G8GYW/g8gyw.github.io/MiniCore.png

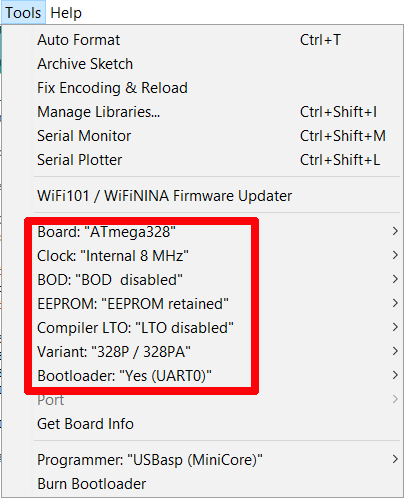
MiniCore.png
