G8GYW/g8gyw.github.io/startup.png

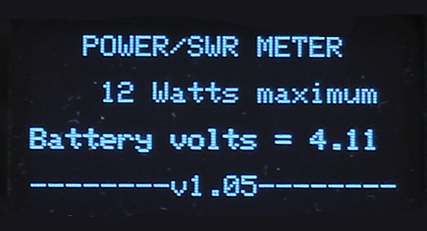
startup.png
