G8GYW/g8gyw.github.io/operating.png

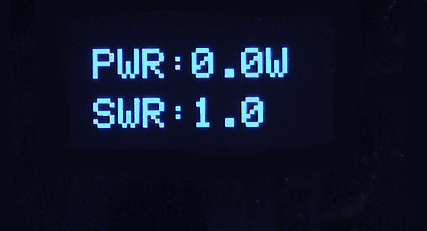
operating.png
