G8GYW/g8gyw.github.io/(threads)

Thread 1 (2022-10-02):

missing filter.h

owenduffy, 2022-10-02:
Hi, I tried to build the code and it seems filter.h is missing?

Owen

G8GYW, 2022-10-02:
Hi, you need to download the library from here:

https://www.megunolink.com/documentation/arduino-library/

The design has been cloned here:

https://m.aliexpress.com/item/1005003876018063.html

Mike

owenduffy, 2022-10-02:
Thanks, I had guessed that MLP was a likely candidate. For PlatformIO, it builds with:

lib_deps = adafruit/Adafruit SSD1306@^2.5.7
           git@github.com:Megunolink/MLP.git

Yes, I purchased one of those Aliexpress implementations to try both your curve fitting technique and a cubic spline fit.

Thanks
Owen

G8GYW, 2022-10-02:
Let me know how you get on!

Mike

owenduffy, 2022-10-02:
Ok. A series of blog articles develops the fit alternatives starting at [Digital display for DIY 25W dummy load – part 1](https://owenduffy.net/blog/?p=26018).

I forked your repo and made some changes to build using PlatformIO.

I await the thing on a slow boat from China (currently 2-12weeks).

Owen

G8GYW, 2022-10-02:
Thanks Owen.

Mike

Closed 2022-10-02.
